filada/WeatherStation_V2/HW/PDF/WeatherStation_V2__Assembly.pdf

J9 D1 | SW1 | FLASH C¹⁵ 1 | 2 | 3 | 4 | 5 | 6 1 | 2 | 3 | 4 | 5 | 6 ABCD | ABCD Date: 2023-12-15 KiCad | E.D.A. 9.0.1 Size: A4 | Rev: 2.0

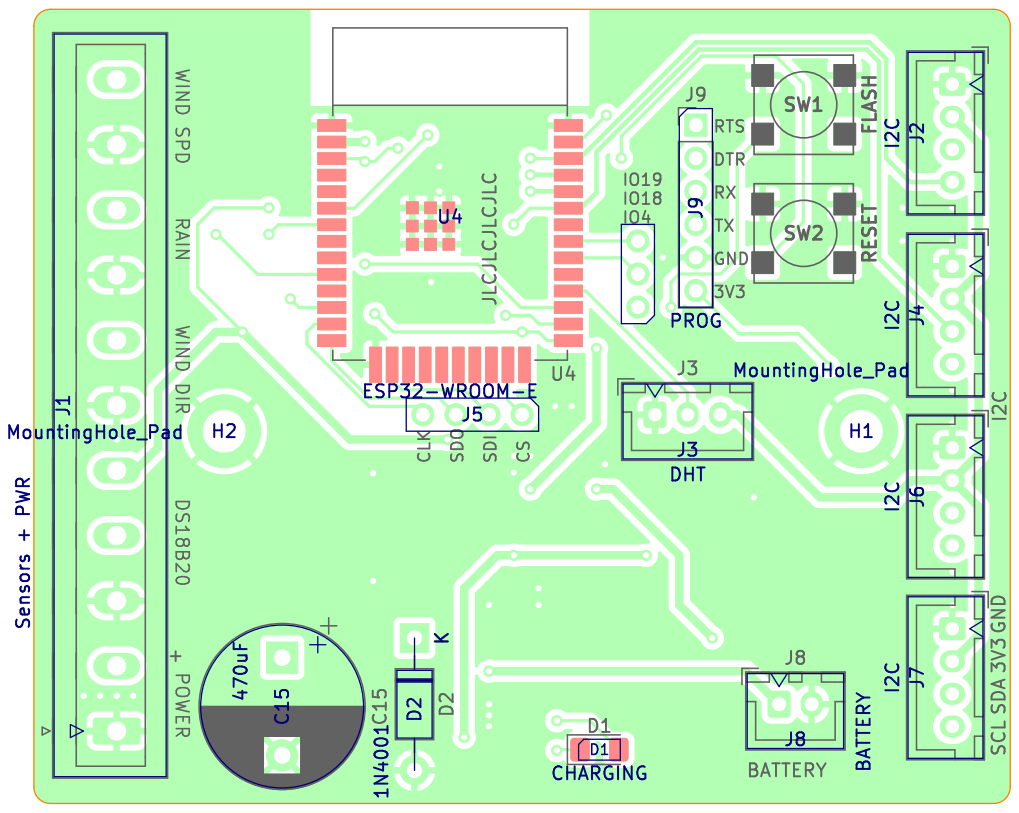
[picture p1: page 1]
3V3 CLK; GND; RTS; DTR; GND SDI JLCJLCJLCJLC; TX POWER; SDO; BATTERY +; SDA WIND DIR; SCL WIND SPD; 3V³ RAIN; RESET; Filada ESP32 Weather Station Board2Pdf:; Colored-TOP; Page; ESP32-WROOM-E U4; BATTERY J8; I2CJ2 I2CJ4 1N⁴⁰⁰¹; K D² Sensors + PWR; MountingHole_Pad H1 I2CJ6 MountingHole_Pad; DHT; J3 PROGJ9 CHARGING; D1 ⁴⁷⁰uF; C¹⁵

File: WeatherStation_V2.kicad_pcb Sheet: Colored-TOP
Id: /1 Title: WeatherStation_V2

1 | 2 | 3 | 4 | 5 | 6

A

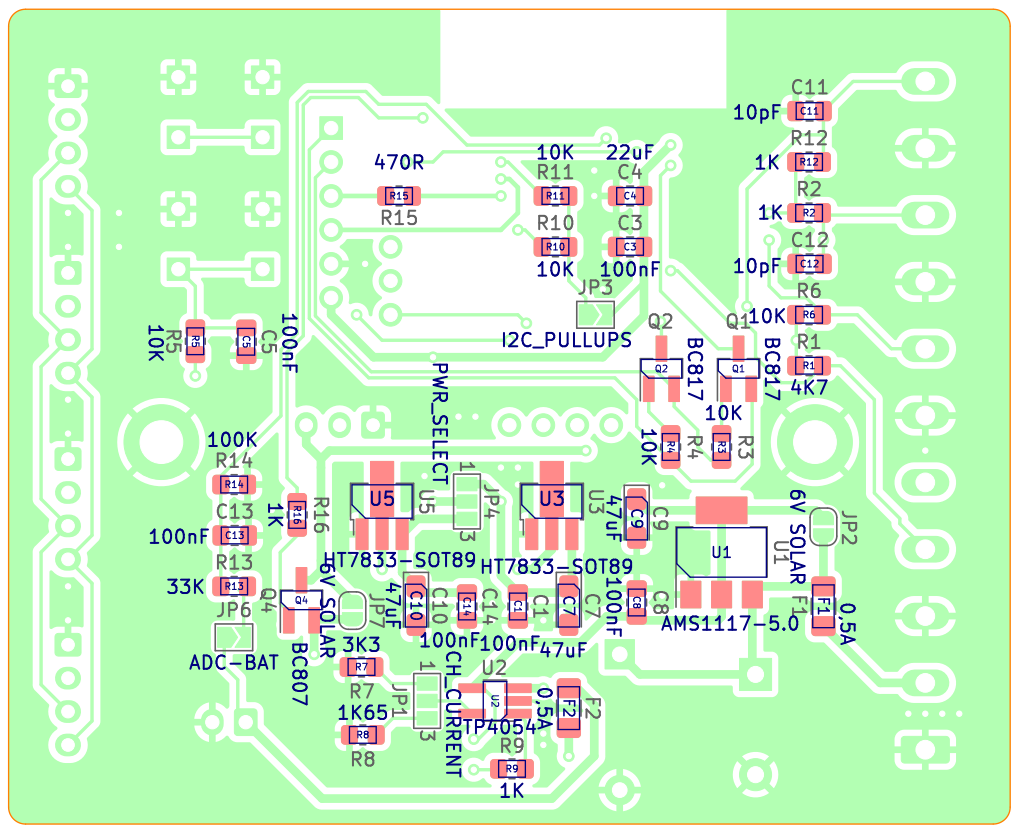
[picture p2: page 2]

File: WeatherStation_V2.kicad_pcb Sheet: Colored-BOT
Id: /1 Title: WeatherStation_V2
