filada/WeatherStation_V2/HW/PDF/WeatherStation_V2_SCH.pdf

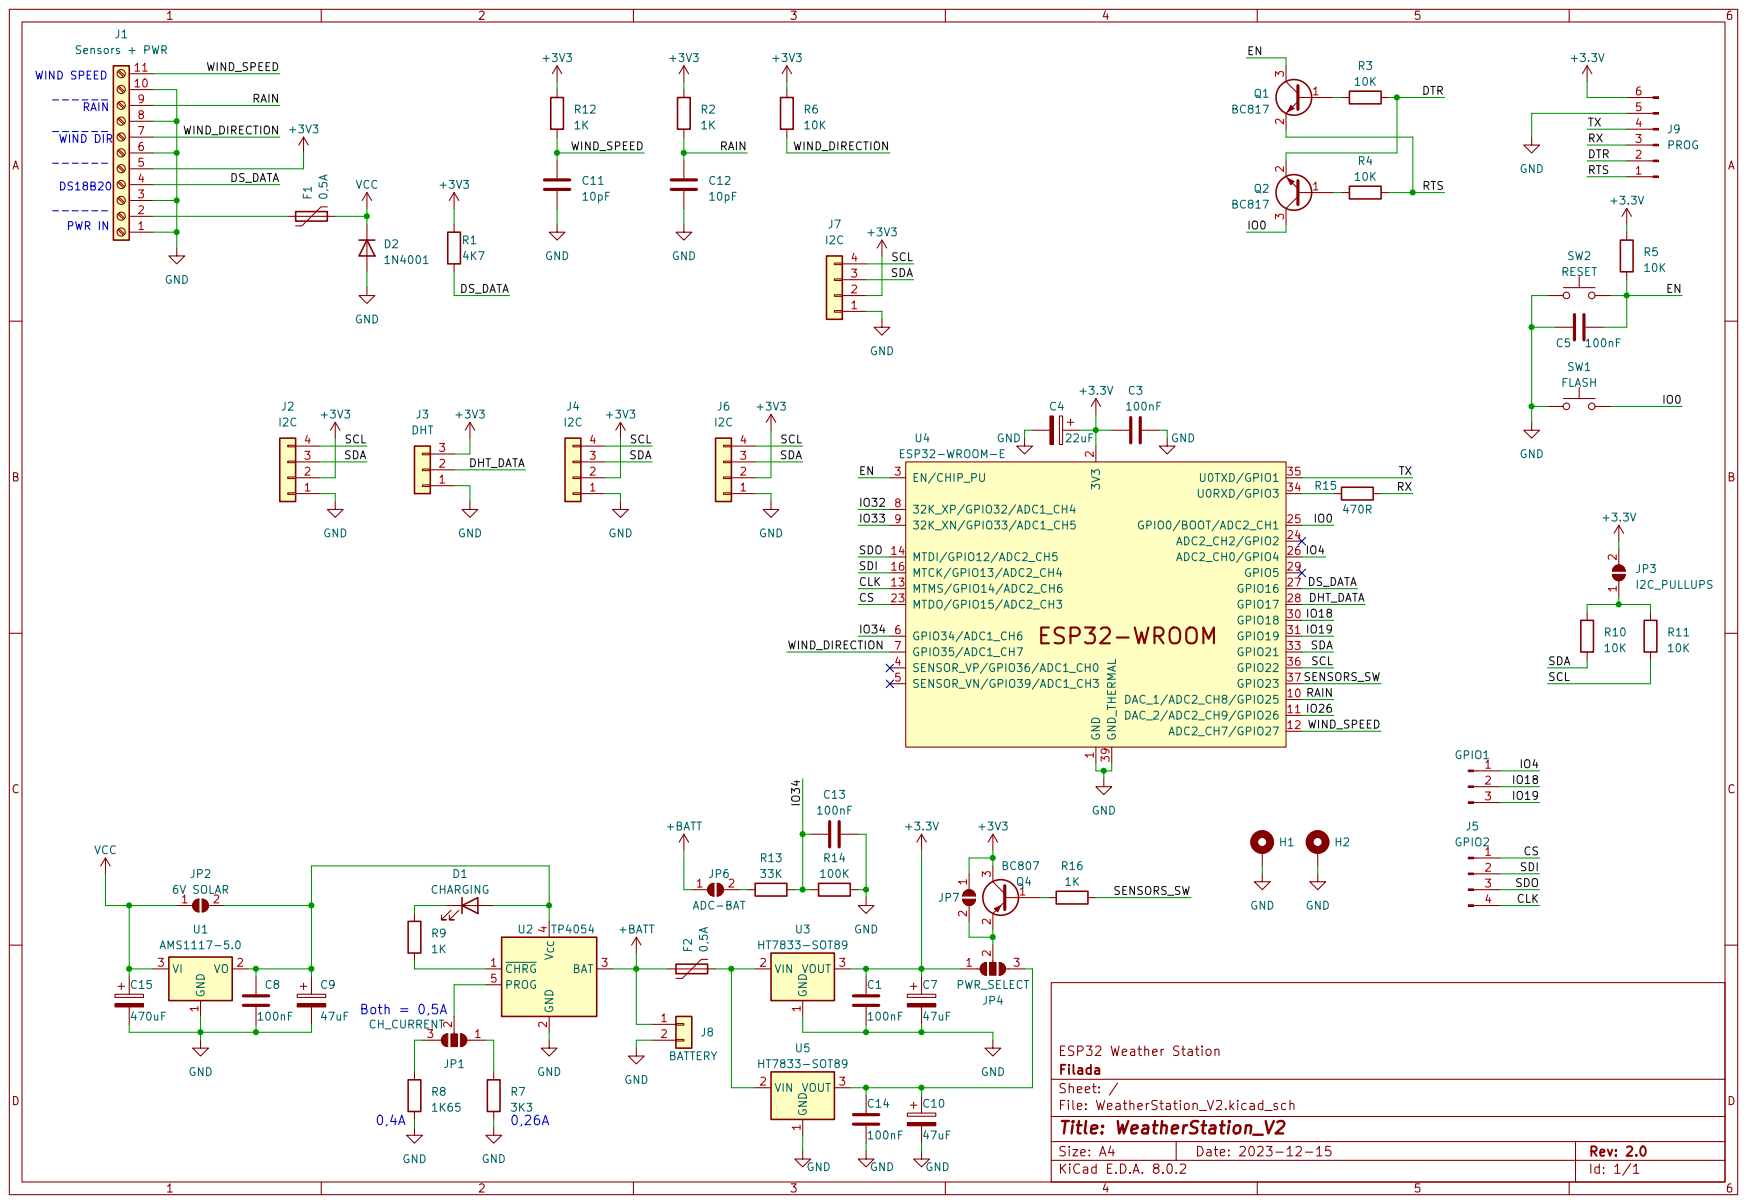
[picture p3: page 1]
