filada/WeatherStation_V2/HW/WeatherStation_V2.kicad_pcb

## KiCad design HW/WeatherStation_V2.kicad_pcb (2024-06-22)

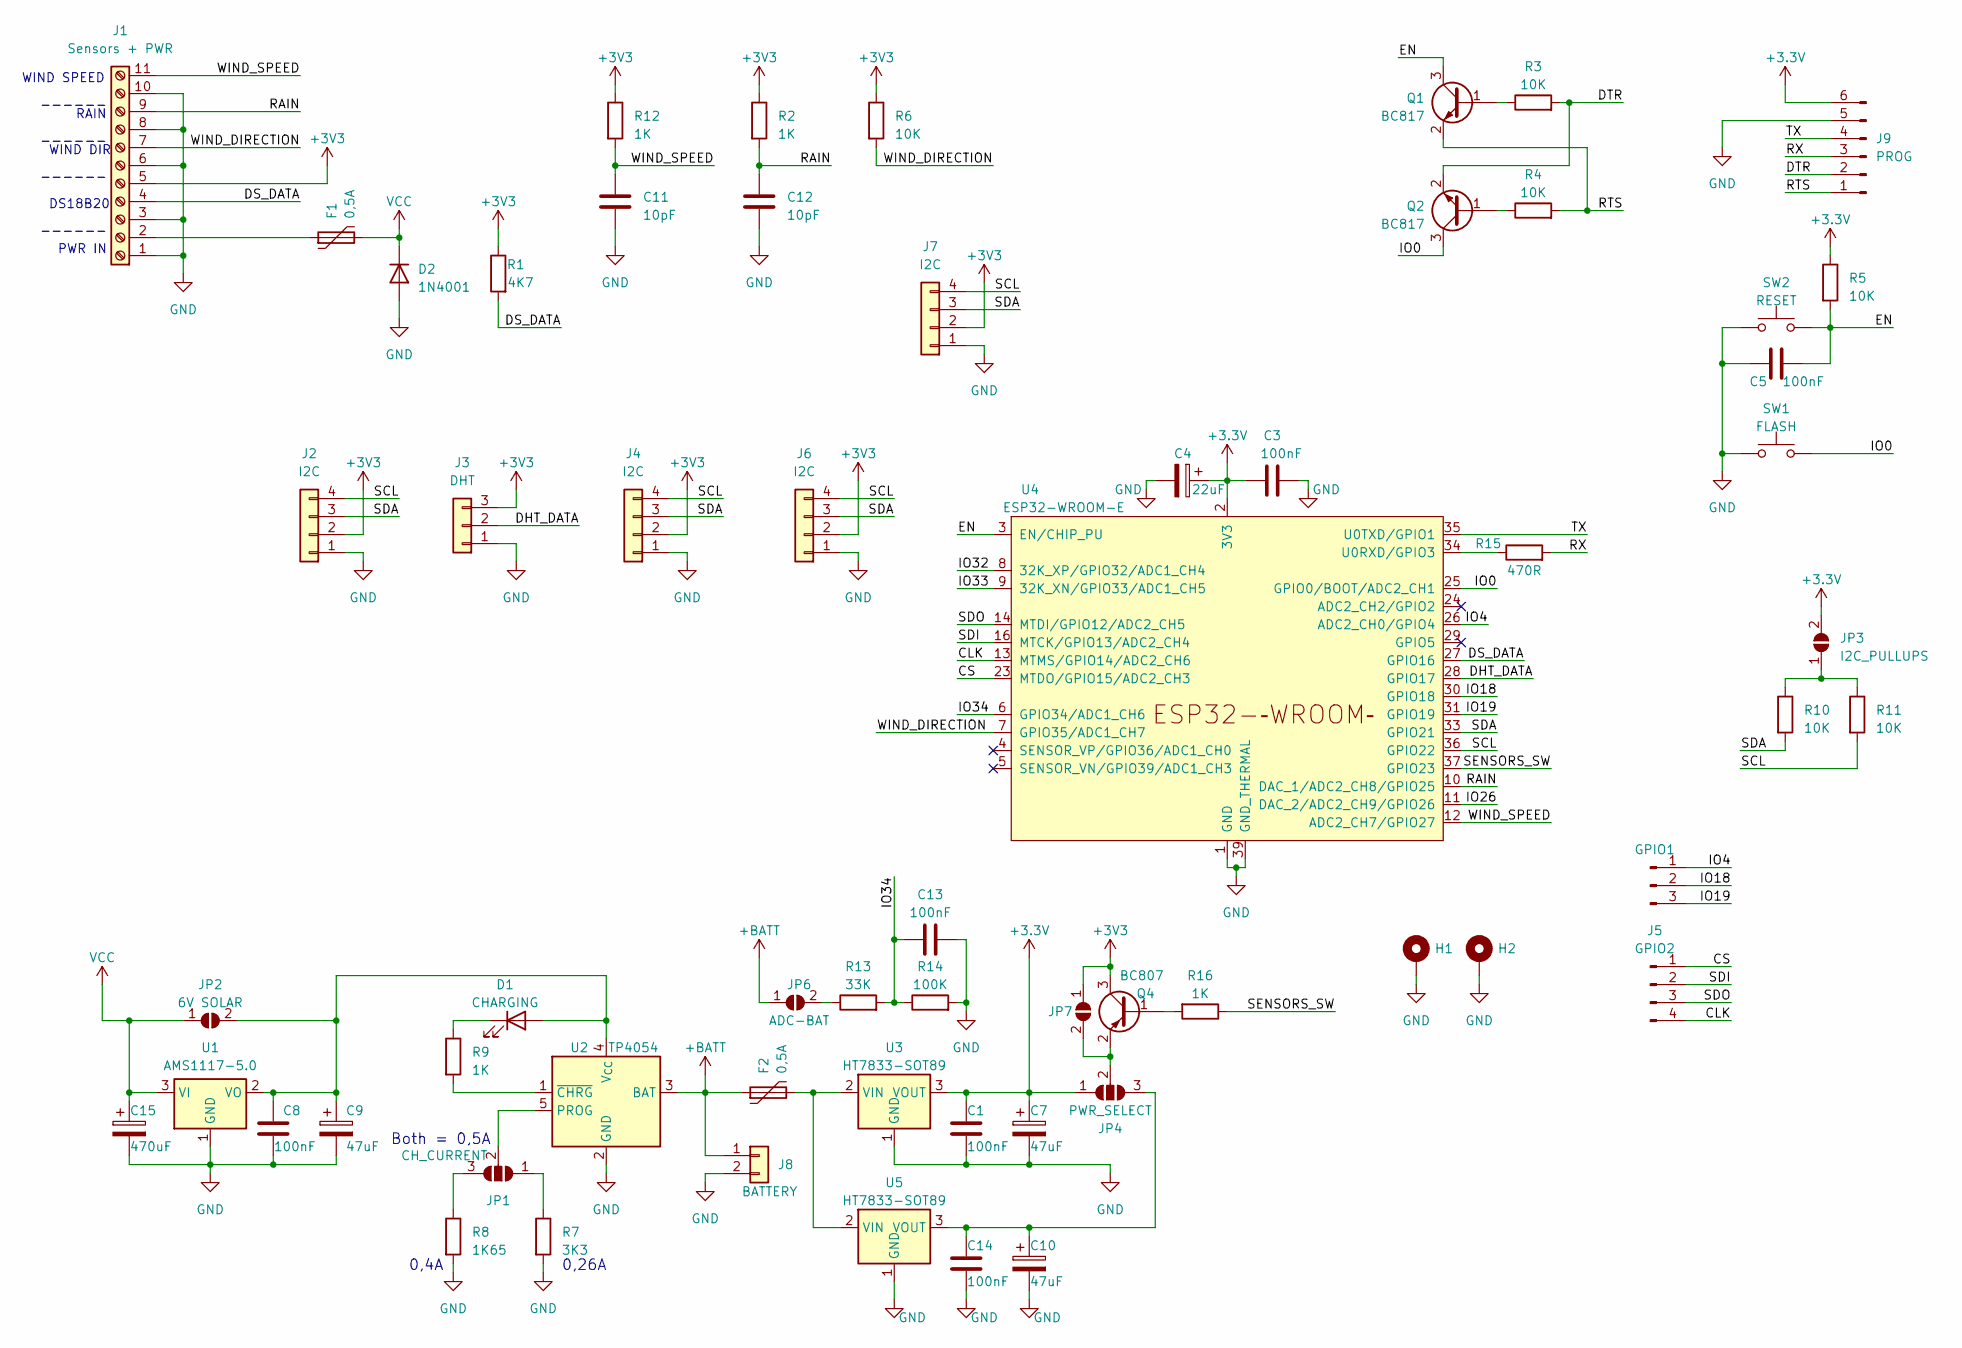
[picture p4: schematic WeatherStation_V2.kicad_sch]

Parts:
C1, C3, C5, C8, C13, C14: 100nF; C_0805_2012Metric_Pad1.18x1.45mm_HandSolder
C4: 22uF; C_0805_2012Metric_Pad1.18x1.45mm_HandSolder
C7, C9, C10: 47uF; CP_EIA-3216-18_Kemet-A_Pad1.58x1.35mm_HandSolder
C11, C12: 10pF; C_0805_2012Metric_Pad1.18x1.45mm_HandSolder
C15: 470uF; CP_Radial_D12.5mm_P7.50mm
D1: CHARGING; LED_1206_3216Metric_Pad1.42x1.75mm_HandSolder
D2: 1N4001; D_DO-41_SOD81_P10.16mm_Horizontal
F1, F2: 0,5A; Fuse_1206_3216Metric_Pad1.42x1.75mm_HandSolder
GPIO1: Conn_01x03_Pin; PinHeader_1x03_P2.54mm_Vertical
H1, H2: MountingHole_Pad; MountingHole_3.2mm_M3_DIN965_Pad
J1: Sensors + PWR; ScrewTerminal_1x11_P5.00mm_Vertical
J2, J4, J6, J7: I2C; JST_XH_B4B-XH-A_1x04_P2.50mm_Vertical
J3: DHT; JST_XH_B3B-XH-A_1x03_P2.50mm_Vertical
J5: GPIO2; PinHeader_1x04_P2.54mm_Vertical
J8: BATTERY; JST_XH_B2B-XH-A_1x02_P2.50mm_Vertical
J9: PROG; PinHeader_1x06_P2.54mm_Vertical
JP1: CH_CURRENT; SolderJumper-3_P1.3mm_Open_Pad1.0x1.5mm_NumberLabels
JP2, JP7: 6V SOLAR; SolderJumper-2_P1.3mm_Open_RoundedPad1.0x1.5mm
JP3: I2C_PULLUPS; SolderJumper-2_P1.3mm_Open_TrianglePad1.0x1.5mm
JP4: PWR_SELECT; SolderJumper-3_P1.3mm_Open_Pad1.0x1.5mm_NumberLabels
JP6: ADC-BAT; SolderJumper-2_P1.3mm_Open_TrianglePad1.0x1.5mm
Q1, Q2: BC817; SOT-23_Handsoldering
Q4: BC807; SOT-23_Handsoldering
R1: 4K7; R_0805_2012Metric_Pad1.20x1.40mm_HandSolder
R2, R9, R12, R16: 1K; R_0805_2012Metric_Pad1.20x1.40mm_HandSolder
R3, R4, R5, R6, R10, R11: 10K; R_0805_2012Metric_Pad1.20x1.40mm_HandSolder
R7: 3K3; R_0805_2012Metric_Pad1.20x1.40mm_HandSolder
R8: 1K65; R_0805_2012Metric_Pad1.20x1.40mm_HandSolder
R13: 33K; R_0805_2012Metric_Pad1.20x1.40mm_HandSolder
R14: 100K; R_0805_2012Metric_Pad1.20x1.40mm_HandSolder
R15: 470R; R_0805_2012Metric_Pad1.20x1.40mm_HandSolder
SW1: FLASH; SW_PUSH_SMALL
SW2: RESET; SW_PUSH_SMALL
U1: AMS1117-5.0; SOT-223-3_TabPin2
U2: TP4054; TSOT-23-5_HandSoldering
U3, U5: HT7833-SOT89; SOT-89-3_Handsoldering
U4: ESP32-WROOM-E; ESP32-WROOM-32E_HandSolder

Connections:
+3.3V: C1.1, C3.1, C4.1, C7.1, J9.6, JP3.2 (B), JP4.1 (A), R5.1, U3.3 (VOUT), U4.2 (3V3)
+3V3: J1.5, J2.2, J3.3, J4.2, J6.2, J7.2, JP7.1 (A), Q4.3 (C), R1.1, R2.1, R6.1, R12.1
+BATT: F2.1, J8.1, JP6.1 (A), U2.3 (BAT)
/CLK: J5.4, U4.13 (MTMS/GPIO14/ADC2_CH6)
/CS: J5.1, U4.23 (MTDO/GPIO15/ADC2_CH3)
/DHT_DATA: J3.2, U4.28 (GPIO17)
/DS_DATA: J1.4, R1.2, U4.27 (GPIO16)
/DTR: J9.2, Q2.2 (E), R3.2
/EN: C5.1, Q1.3 (C), R5.2, SW2.2, U4.3 (EN/CHIP_PU)
/IO0: Q2.3 (C), SW1.2, U4.25 (GPIO0/BOOT/ADC2_CH1)
/IO4: GPIO1.1, U4.26 (ADC2_CH0/GPIO4)
/IO18: GPIO1.2, U4.30 (GPIO18)
/IO19: GPIO1.3, U4.31 (GPIO19)
/IO26: U4.11 (DAC_2/ADC2_CH9/GPIO26)
/IO32: U4.8 (32K_XP/GPIO32/ADC1_CH4)
/IO33: U4.9 (32K_XN/GPIO33/ADC1_CH5)
/IO34: C13.1, R13.2, R14.1, U4.6 (GPIO34/ADC1_CH6)
/RAIN: C12.1, J1.9, R2.2, U4.10 (DAC_1/ADC2_CH8/GPIO25)
/RTS: J9.1, Q1.2 (E), R4.2
/RX: J9.3, R15.2
/SCL: J2.4, J4.4, J6.4, J7.4, R11.2, U4.36 (GPIO22)
/SDA: J2.3, J4.3, J6.3, J7.3, R10.2, U4.33 (GPIO21)
/SDI: J5.2, U4.16 (MTCK/GPIO13/ADC2_CH4)
/SDO: J5.3, U4.14 (MTDI/GPIO12/ADC2_CH5)
/SENSORS_SW: R16.1, U4.37 (GPIO23)
/TX: J9.4, U4.35 (U0TXD/GPIO1)
/WIND_DIRECTION: J1.7, R6.2, U4.7 (GPIO35/ADC1_CH7)
/WIND_SPEED: C11.1, J1.11, R12.2, U4.12 (ADC2_CH7/GPIO27)
GND: C1.2, C3.2, C4.2, C5.2, C7.2, C8.2, C9.2, C10.2, C11.2, C12.2, C13.2, C14.2, C15.2, D2.2 (A), H1.1, H2.1, J1.1, J1.3, J1.6, J1.8, J1.10, J2.1, J3.1, J4.1, J6.1, J7.1, J8.2, J9.5, R7.2, R8.2, R14.2, SW1.1, SW2.1, U1.1 (GND), U2.2 (GND), U3.1 (GND), U4.1 (GND), U4.15 (GND), U4.38 (GND), U4.39 (GND_THERMAL), U5.1 (GND)
unnamed: C8.1, C9.1, D1.2 (A), JP2.2 (B), U1.2 (VO), U2.4 (V_{CC})
unnamed: D1.1 (K), R9.1
unnamed: F1.1, J1.2
unnamed: JP1.1 (A), R7.1
unnamed: JP1.3 (B), R8.1
unnamed: JP1.2 (C), U2.5 (PROG)
unnamed: JP3.1 (A), R10.1, R11.1
unnamed: C10.1, C14.1, JP4.3 (B), U5.3 (VOUT)
unnamed: JP4.2 (C), JP7.2 (B), Q4.2 (E)
unnamed: JP6.2 (B), R13.1
unnamed: Q1.1 (B), R3.1
unnamed: Q2.1 (B), R4.1
unnamed: Q4.1 (B), R16.2
unnamed: R9.2, U2.1 (~CHRG)
unnamed: F2.2, U3.2 (VIN), U5.2 (VIN)
unnamed: R15.1, U4.34 (U0RXD/GPIO3)
VCC: C15.1, D2.1 (K), F1.2, JP2.1 (A), U1.3 (VI)

Notes on the sheet:
WIND SPEED
------
PWR IN
0,26A
RAIN
Both = 0,5A
DS18B20
WIND DIR
0,4A

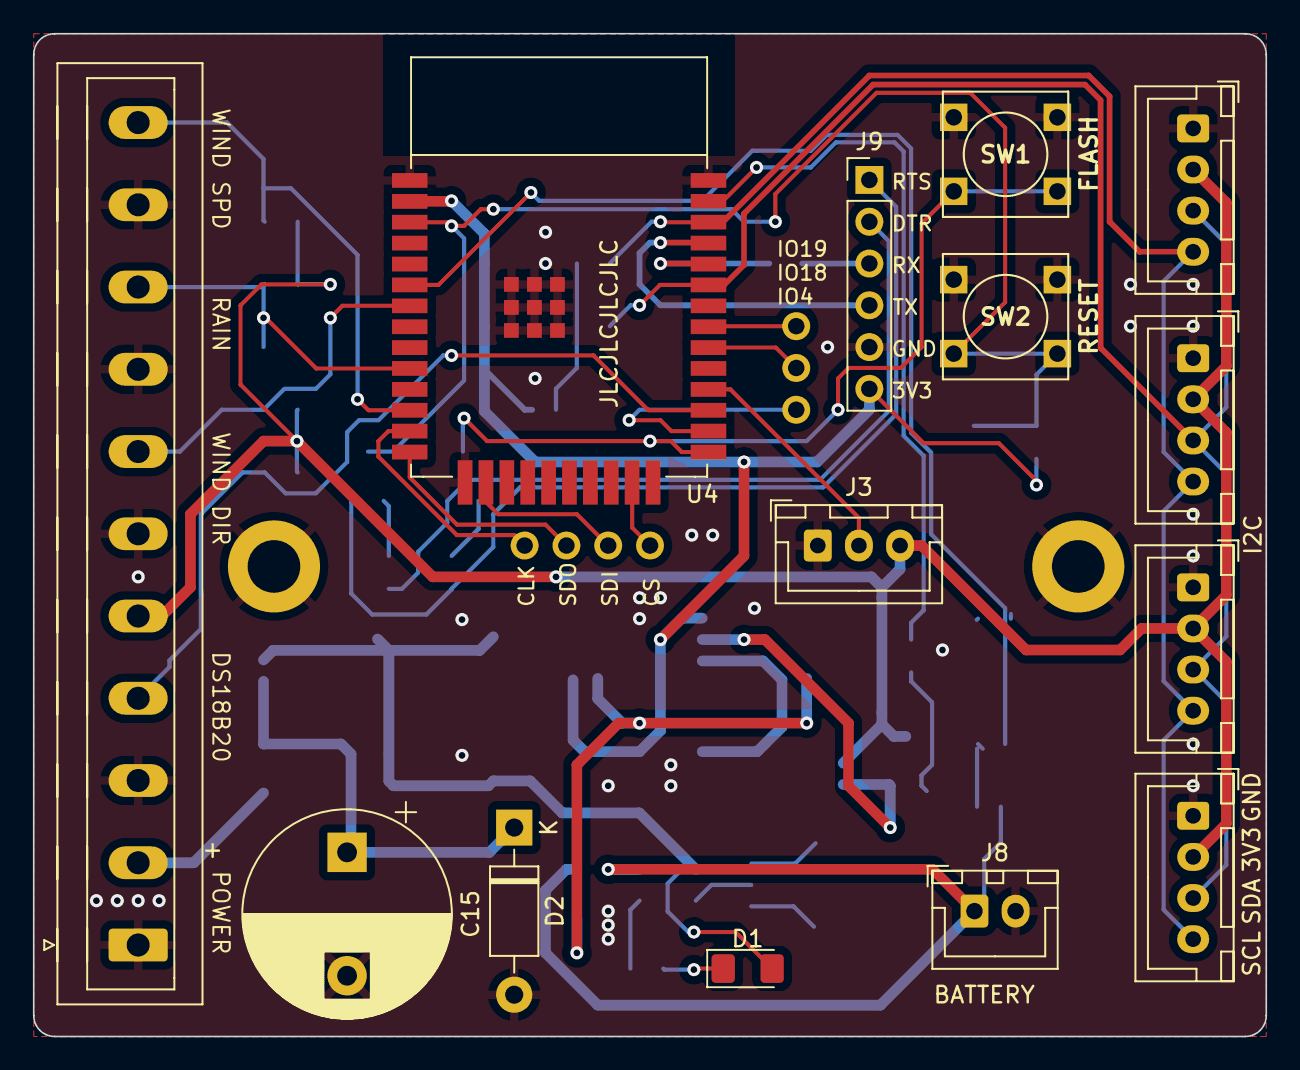
[picture p5: board WeatherStation_V2.kicad_pcb from above]

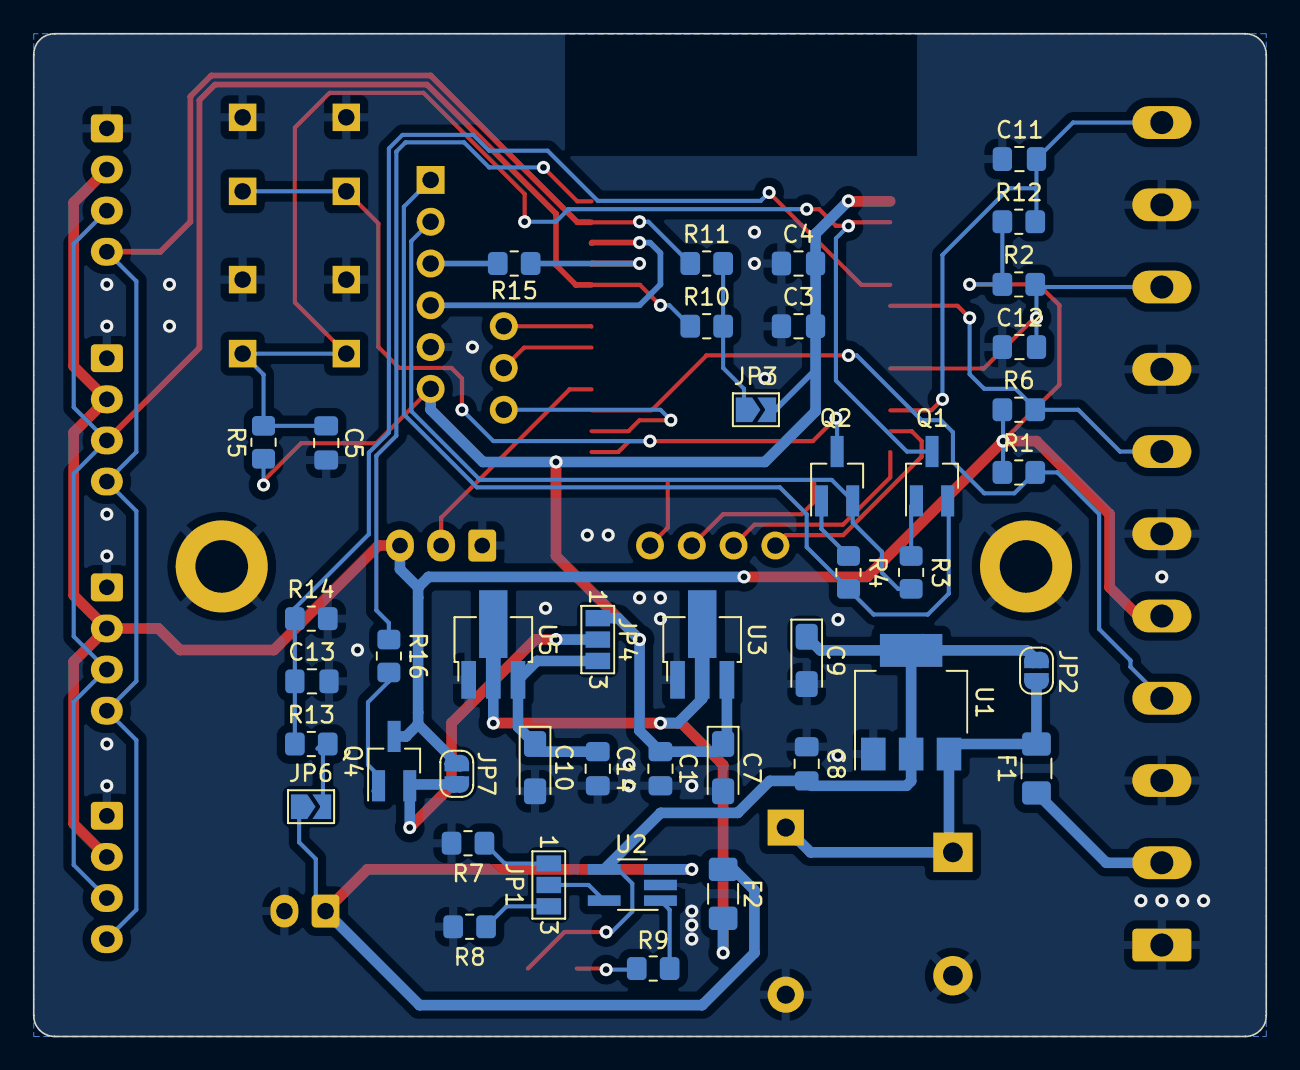
[picture p6: board WeatherStation_V2.kicad_pcb from below]

Board: 2 copper layers, 74.9 x 61.0 mm, 61 parts (43 on the bottom side), 43 nets.
