filada/WeatherStation_V2/(commit log)

2023-12-10 first version of PCB
    [WeatherStation_V2.kicad_pcb, WeatherStation_V2.kicad_sch]
2023-12-10 PCB files moved to PCB folder
    [WeatherStation_V2.kicad_pcb, WeatherStation_V2.kicad_sch]
2023-12-10 folder PCB renamed to HW
    [WeatherStation_V2.kicad_pcb, WeatherStation_V2.kicad_sch]
2023-12-15 Updated PCB - DRC OK
    DRC without any error;
    some small improvements in scheme
    [WeatherStation_V2.kicad_pcb, WeatherStation_V2.kicad_sch]
2023-12-16 small improvements
    [WeatherStation_V2.kicad_pcb]
2023-12-22 added keepout area
    Updated antenna area - added keepout area
    Updated text on Silkscreen layer
    [WeatherStation_V2.kicad_pcb]
2024-01-30 3 pin battery connector updated to 2 pin
    [WeatherStation_V2.kicad_pcb, WeatherStation_V2.kicad_sch]
2024-02-17 Updated design rules
    Updated for production in JLCPCB
    [WeatherStation_V2.kicad_pcb]
2024-07-17 Create WeatherStation_V2_SCH.pdf
    Added PDF schematic
2025-05-08 First FW
    Added PCB Assembly PDF, organized folders, added basic firmware
